DRAMCO/KiCAD-components/README.md

# Dracmo KiCAD Component Library

This repository contains our KiCAD component library including:

- **Symbols**
- **Footprints**
- **3D Models**

The library is organized by **manufacturer**, and each symbol includes the following additional fields:

- `Part Number`
- `Manufacturer`
- `Supplier`
- `Supplier Part Number`

## Footprint Standards

All footprints are designed with the following conventions:

- **Silkscreen Text**:
  - Thickness: `0.15mm` with height `1mm`, or
  - Thickness: `0.13mm` with height `0.7mm`
- **Silkscreen Lines**:
  - Standard thickness: `0.2mm`
  - For extremely small components: `0.1mm`
- **Courtyards**:
  - Line thickness: `0.1mm`
- **3D Models**:
  - Included where available
- **Silkscreen and Courtyard**:
  - Properly drawn and aligned

## Usage

This library is **free to use** under an open-source license. You are welcome to integrate it into your KiCAD projects.

## Contributions & Issues

We kindly ask users to **report any issues** with the models via the GitHub Issues tab. Contributions and suggestions are welcome to help improve the library.

## Disclaimer

> ⚠️ **Disclaimer**:  
> This library is provided **as-is** without any guarantees. While efforts are made to adhere to KiCAD specifications and ensure accuracy, **no liability** is assumed for any errors, inaccuracies, or consequences arising from the use of these components. Use at your own risk.
