DRAMCO/KiCAD-components/3d-models/pxc_1984976_06_02_PTSA-1-5-3-3-5-F_3D.stp

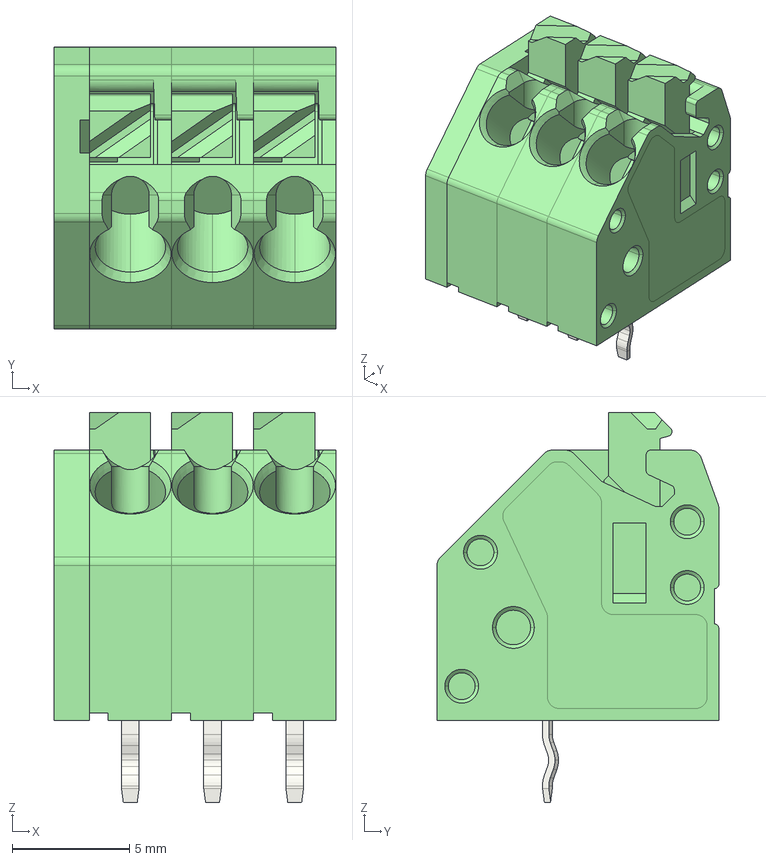
[picture p1: CAD file, 2025-11-27]
3d-models/pxc_1984976_06_02_PTSA-1-5-3-3-5-F_3D.stp
12.0 x 12.0 x 16.6 mm
