DRAMCO/KiCAD-components/3d-models/pxc_1984963_06_02_PTSA-1-5-2-3-5-F_3D.stp

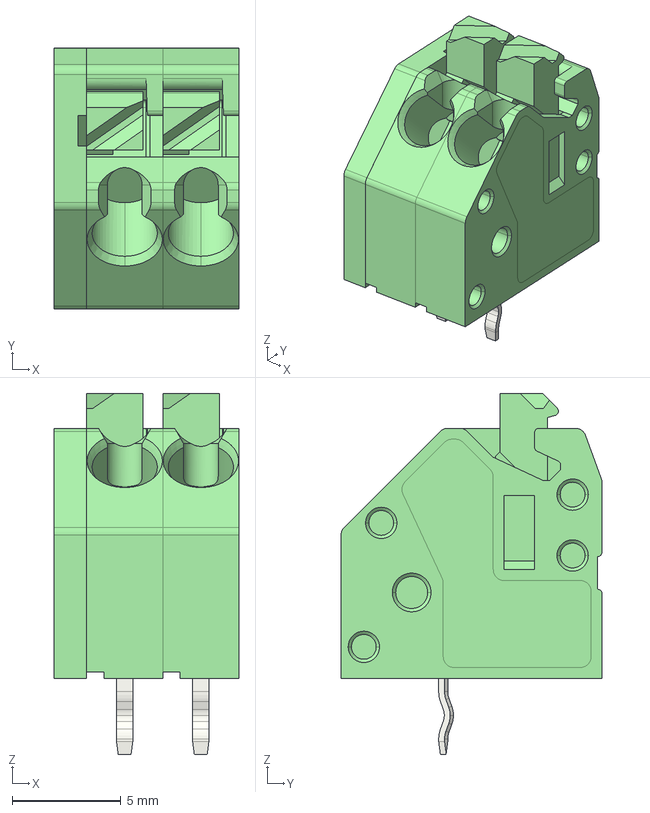
[picture p2: CAD file, 2025-11-14]
3d-models/pxc_1984963_06_02_PTSA-1-5-2-3-5-F_3D.stp
8.50 x 12.0 x 16.6 mm
