DRAMCO/KiCAD-components/3d-models/3310c-125.stp

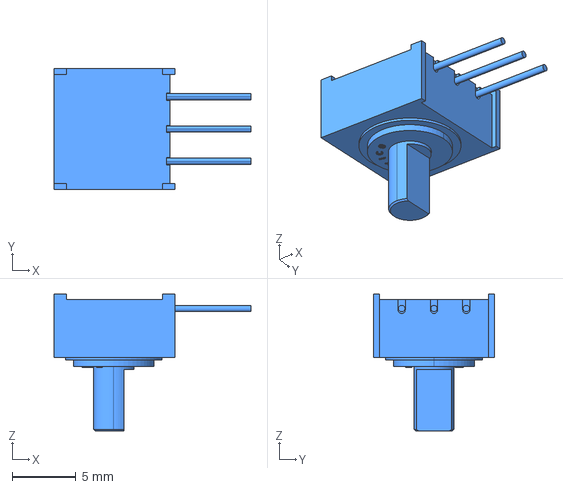
[picture p3: CAD file, 2025-11-14]
3d-models/3310c-125.stp
15.5 x 9.52 x 10.8 mm
