DRAMCO/KiCAD-components/3d-models/Download_STP_WE-XHMI-1090 (rev1).stp

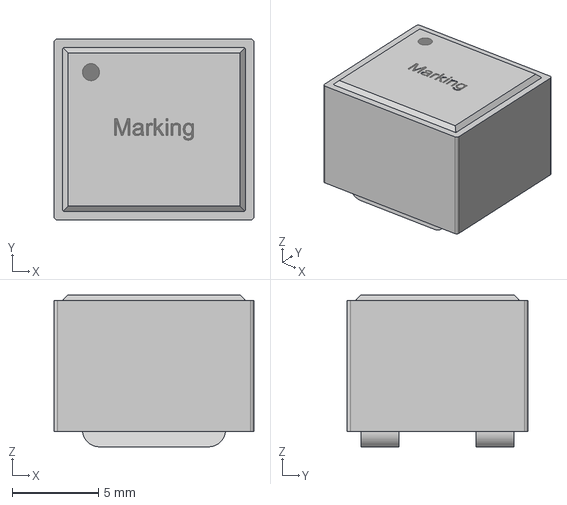
[picture p4: CAD file, 2025-10-28]
3d-models/Download_STP_WE-XHMI-1090 (rev1).stp
11.6 x 10.5 x 8.80 mm
