DRAMCO/KiCAD-components/3d-models/DO-221AC.step

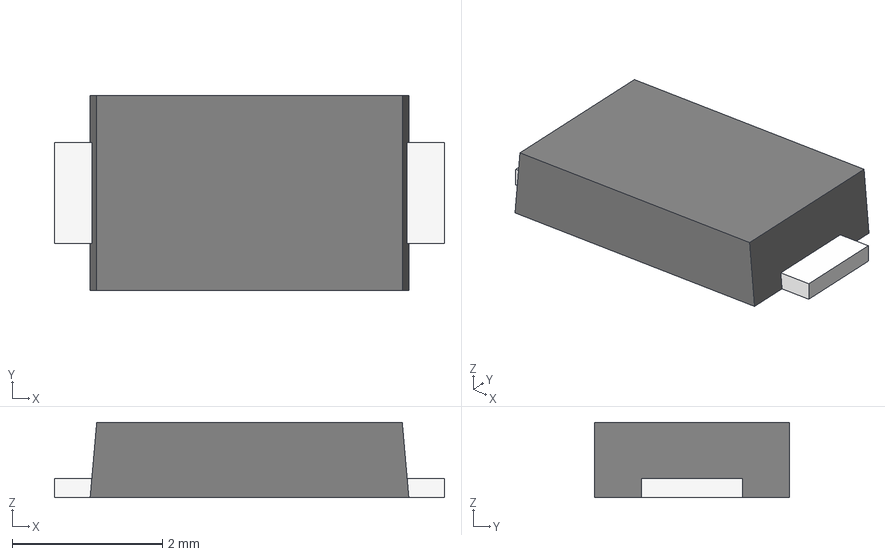
[picture p5: CAD file, 2025-10-28]
3d-models/DO-221AC.step
5.20 x 2.60 x 1.00 mm
