DRAMCO/KiCAD-components/3d-models/WE-PDF_1045 (rev1).stp

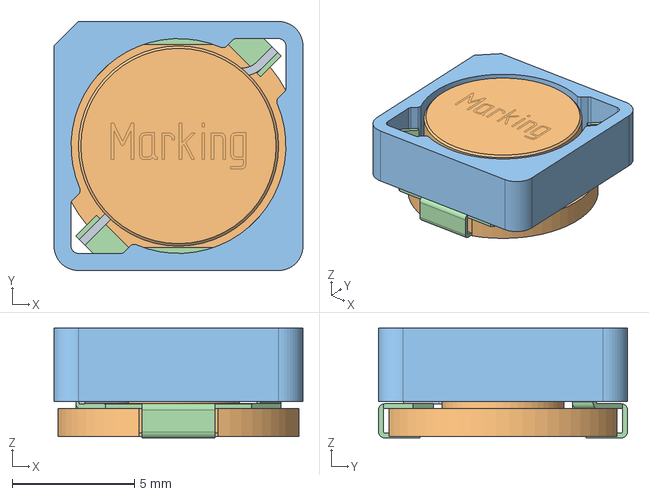
[picture p6: CAD file, 2025-10-28]
3d-models/WE-PDF_1045 (rev1).stp
10.2 x 10.2 x 4.50 mm
