DRAMCO/KiCAD-components/3d-models/Elco_12.5x40_axial.step

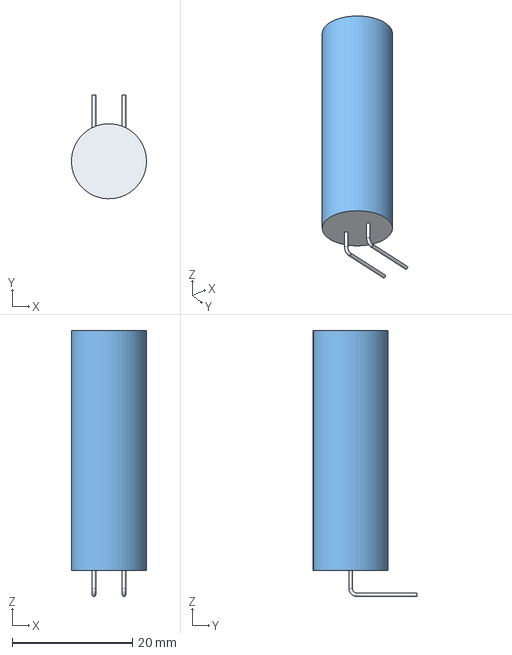
[picture p7: CAD file, 2025-10-28]
3d-models/Elco_12.5x40_axial.step
12.5 x 17.2 x 44.3 mm
