DRAMCO/KiCAD-components/3d-models/WE-SPC_4828SPC (rev1).stp

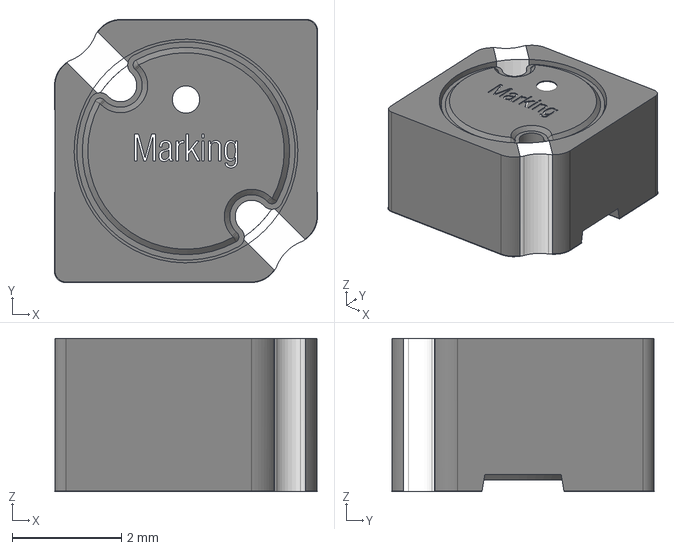
[picture p8: CAD file, 2025-10-28]
3d-models/WE-SPC_4828SPC (rev1).stp
4.82 x 4.82 x 2.81 mm
