DRAMCO/KiCAD-components/3d-models/VQFN-HR-1mm.step

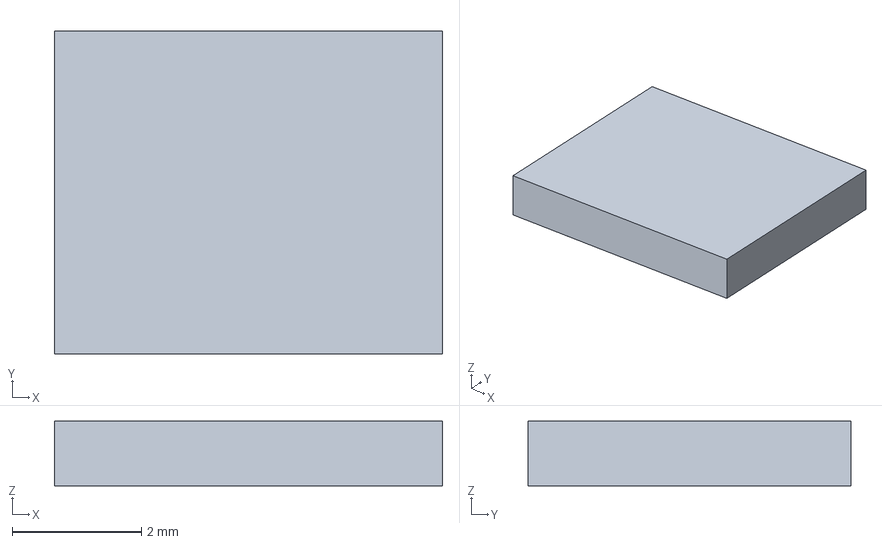
[picture p9: CAD file, 2025-10-28]
3d-models/VQFN-HR-1mm.step
6.00 x 5.00 x 1.00 mm
