DRAMCO/KiCAD-components/(commit log)

2025-10-28 Updated readme. Added currently available component models.
    [DO-221AC.step, Download_STP_WE-XHMI-1090 (rev1).stp, Elco_12.5x40_axial.step, VQFN-HR-1mm.step, WE-PDF_1045 (rev1).stp, WE-SPC_4828SPC (rev1).stp]
2025-11-14 Adding Phoenix Contact PTST 1.5/2-3.5 connector, Bourns 3310C potentiometer, STLQ015M12R and STLQ015M15R.
    [3310c-125.stp, pxc_1984963_06_02_PTSA-1-5-2-3-5-F_3D.stp]
2025-11-27 Adding Wilkinson Power Splitter PD0810J5050S2HF, Phoenix Contact PTSA 3-pin and Mini-Circuits SAV-551+.
    [pxc_1984976_06_02_PTSA-1-5-3-3-5-F_3D.stp]
2026-02-02 Adding Powercast P2110B.
2026-02-02 Adding separate footprints for the PMOD connectors.
2026-05-26 Adding ST STM32U031F8, Abracon ASWD-S2-0003-T, 3-pin 0402 solder jumper (in Generic).
